emeb/bcc_sdr/README.md

bcc_sdr
=======

SDR daughtercard for BCC S6 FPGA board

All Files and Programmes Copyright 2014 Eric Brombaugh and/or Tom King

All Files and Programmes licensed under GPL v2 (See License.txt)
