emeb/bcc_sdr/Documentation/bcc_sdr_bom.ods

refdes | device | value | footprint | qty | tot qty | Manuf PN | Source | Source PN | Price (1) | Price(100) | min qty | 1- ext
C123 | CAPACITOR | 0.01uf | my_0402_sm | 1
C204 | CAPACITOR | 0.01uf | my_0402_sm | 1
C212 | CAPACITOR | 0.01uf | my_0402_sm | 1
C220 | CAPACITOR | 0.01uf | my_0402_sm | 1
C224 | CAPACITOR | 0.01uf | my_0402_sm | 1 | 5 | EMK105B7103KV-F |  | 587-2708-1-ND | $0.10 | $0.01 |  | $0.50
C106 | CAPACITOR | 0.1uf | my_0402_sm | 1
C108 | CAPACITOR | 0.1uf | my_0402_sm | 1
C109 | CAPACITOR | 0.1uf | my_0402_sm | 1
C112 | CAPACITOR | 0.1uf | my_0402_sm | 1
C113 | CAPACITOR | 0.1uf | my_0402_sm | 1
C114 | CAPACITOR | 0.1uf | my_0402_sm | 1
C115 | CAPACITOR | 0.1uf | my_0402_sm | 1
C116 | CAPACITOR | 0.1uf | my_0402_sm | 1
C117 | CAPACITOR | 0.1uf | my_0402_sm | 1
C118 | CAPACITOR | 0.1uf | my_0402_sm | 1
C119 | CAPACITOR | 0.1uf | my_0402_sm | 1
C120 | CAPACITOR | 0.1uf | my_0402_sm | 1
C121 | CAPACITOR | 0.1uf | my_0402_sm | 1
C122 | CAPACITOR | 0.1uf | my_0402_sm | 1
C124 | CAPACITOR | 0.1uf | my_0402_sm | 1
C203 | CAPACITOR | 0.1uf | my_0402_sm | 1
C211 | CAPACITOR | 0.1uf | my_0402_sm | 1
C219 | CAPACITOR | 0.1uf | my_0402_sm | 1
C225 | CAPACITOR | 0.1uf | my_0402_sm | 1
C302 | CAPACITOR | 0.1uf | my_0402_sm | 1
C304 | CAPACITOR | 0.1uf | my_0402_sm | 1
C306 | CAPACITOR | 0.1uf | my_0402_sm | 1
C311 | CAPACITOR | 0.1uf | my_0402_sm | 1
C313 | CAPACITOR | 0.1uf | my_0402_sm | 1
C315 | CAPACITOR | 0.1uf | my_0402_sm | 1 | 25 | EMK105B7104KV-F | digikey | 587-1451-1-ND | $0.10 | $0.01 |  | $2.50
C201 | CAPACITOR | 100pf | my_0402_sm | 1
C209 | CAPACITOR | 100pf | my_0402_sm | 1
C213 | CAPACITOR | 100pf | my_0402_sm | 1
C214 | CAPACITOR | 100pf | my_0402_sm | 1
C215 | CAPACITOR | 100pf | my_0402_sm | 1
C217 | CAPACITOR | 100pf | my_0402_sm | 1
C221 | CAPACITOR | 100pf | my_0402_sm | 1
C223 | CAPACITOR | 100pf | my_0402_sm | 1 | 8 | GRM1555C1H101GA01D | digikey | 490-6188-1-ND | $0.10 | $0.02 |  | $0.80
C301 | CAPACITOR | 10pf | my_0402_sm | 1
C303 | CAPACITOR | 10pf | my_0402_sm | 1
C305 | CAPACITOR | 10pf | my_0402_sm | 1
C310 | CAPACITOR | 10pf | my_0402_sm | 1
C312 | CAPACITOR | 10pf | my_0402_sm | 1
C314 | CAPACITOR | 10pf | my_0402_sm | 1 | 6 | GRM1555C1H100GA01D | digikey | 490-6187-1-ND | $0.10 | $0.03 |  | $0.60
C202 | CAPACITOR | 10uf 16V | my_0805 | 1
C210 | CAPACITOR | 10uf 16V | my_0805 | 1
C218 | CAPACITOR | 10uf 16V | my_0805 | 1
C226 | CAPACITOR | 10uf 16V | my_0805 | 1
C101 | CAPACITOR | 10uf 16V | my_0805 | 1
C102 | CAPACITOR | 10uf 16V | my_0805 | 1
C103 | CAPACITOR | 10uf 16V | my_0805 | 1
C107 | CAPACITOR | 10uf 16V | my_0805 | 1 | 8 | CL21B106KOQNNNE | digikey | 1276-2872-1-ND | $0.30 | $0.12 |  | $2.40
C309 | CAPACITOR | 1200pf | my_0402_sm | 1
C318 | CAPACITOR | 1200pf | my_0402_sm | 1 | 2 | CL05B122KB5NNNC | Digikey | 1276-1515-1-ND | $0.10 | $0.01 |  | $0.20
C104 | CAPACITOR | 18pf | my_0402_sm | 1
C105 | CAPACITOR | 18pf | my_0402_sm | 1 | 2 | GRM1555C1H180GA01D | Digikey | 490-6204-1-ND | $0.10 | $0.02 |  | $0.20
C319 | CAPACITOR | 1nf | my_0402_sm | 1
C320 | CAPACITOR | 1nf | my_0402_sm | 1
C321 | CAPACITOR | 1nf | my_0402_sm | 1
C322 | CAPACITOR | 1nf | my_0402_sm | 1 | 4 | CL05B102KB5NNNC | Digikey | 1276-1032-1-ND | $0.10 | $0.01 |  | $0.40
C205 | CAPACITOR | 200pf | my_0402_sm | 1
C208 | CAPACITOR | 200pf | my_0402_sm | 1 | 2 | GRM1555C1H201GA01D | Digikey | 490-6218-1-ND | $0.15 | $0.05 |  | $0.30
C307 | CAPACITOR | 2700pf | my_0402_sm | 1
C316 | CAPACITOR | 2700pf | my_0402_sm | 1 | 2 | CL05B272KB5NNNC | Digikey | CL05B272KB5NNNC | $0.10 | $0.01 |  | $0.20
C110 | CAPACITOR | 33pf | my_0402_sm | 1
C111 | CAPACITOR | 33pf | my_0402_sm | 1 | 2 | GRM1555C1H330GA01D | Digikey | 490-6232-1-ND | $0.10 | $0.02 |  | $0.20
C308 | CAPACITOR | 39nf | my_0402_sm | 1
C317 | CAPACITOR | 39nf | my_0402_sm | 1 | 2 | GRM1555C1H390GA01D | Digikey | 490-6235-1-ND | $0.10 | $0.02 |  | $0.20
C206 | CAPACITOR | 47pf | my_0402_sm | 1
C207 | CAPACITOR | 47pf | my_0402_sm | 1 | 2 | GRM1555C1H470GA01D | Digikey | 490-8206-1-ND | $0.10 | $0.02 |  | $0.20
D101 | DIODE | 1N4001 | SOD123 | 1
D301 | DIODE | 1N4001 | SOD123 | 1 | 2 | PMEG2010ER,115 | Digikey | 568-6504-1-ND | $0.48 | $0.21 |  | $0.96
J101 | HEADER46 | unknown | SHIELD-538-476_Lairdtech | 1 | 1 | FX2CA-40P-1.27DSA(71) | Digikey | H10567-ND | $3.83 | $3.06 |  | $3.83
J102 | HEADER8 | unknown | CONNECTOR 3 2 | 1 | 1
J103 | CONNECTOR_4 | unknown | JUMPER4 | 1 | 1
J104 | JUMPER | unknown | HEADER2_2 | 1 | 1
J201 | BNC | unknown | SMA_ENDLAUNCH | 1
J202 | BNC | unknown | SMA_ENDLAUNCH | 1 | 2 | 142-0701-801 | digikey | J502-ND | $5.09 | $3.33 |  | $10.18
L203 | INDUCTOR | 120nH | my_0402_sm | 1 | 1 | MLG1005SR12JT000 | Digikey | 445-3072-1-ND | $0.10 | $0.03 |  | $0.10
L202 | INDUCTOR | 180nH | my_0402_sm | 1
L204 | INDUCTOR | 180nH | my_0402_sm | 1 | 2 | MLF1005LR18K | Digikey | 445-6210-1-ND | $0.28 | $0.18 |  | $0.56
L101 | INDUCTOR | 2.2uH | vlf3010 | 1
L102 | INDUCTOR | 2.2uH | vlf3010 | 1 | 2 | VLF3010AT-2R2M1R0 | Digikey | 445-3215-1-ND | $0.90 | $0.60 |  | $1.80
L201 | INDUCTOR | 1.5uH | my_0805 | 1
L205 | INDUCTOR | 1.5uH | my_0805 | 1
L207 | INDUCTOR | 1.5uH | my_0805 | 1 | 3 | MLF2012A2R2KT000 | Digikey | 445-1051-1-ND | $0.20 | $0.11 |  | $0.60
L206 | INDUCTOR | 1.5uH | 1206_sm | 1 | 1 | CV201210-1R5K | Digikey | CV201210-1R5KCT-ND | $0.10 | $0.04 |  | $0.10
Q301 | BC817-25-7-F | unknown | SOT23-95P-240L1-3N__On-Semi_318-08-Package | 1 | 1 | BC817-25-7-F | Digikey | BC817-25FDICT-ND | $0.21 | $0.07 |  | $0.21
R105 | RESISTOR | 0 | my_0402_sm | 1 | 1 | RC0402FR-070RL | Digikey | 311-0LRCT-ND | $0.10 | $0.01 |  | $0.10
R108 | RESISTOR | 0 | my_0805 | 1
R109 | RESISTOR | 0 | my_0805 | 1 | 2 | RC0805JR-070RL | Digikey | 311-0.0ARCT-ND | $0.10 | $0.01 |  | $0.20
R304 | RESISTOR | 50 | my_0402_sm | 1
R305 | RESISTOR | 50 | my_0402_sm | 1
R306 | RESISTOR | 50 | my_0402_sm | 1
R307 | RESISTOR | 50 | my_0402_sm | 1
R311 | RESISTOR | 50 | my_0402_sm | 1
R312 | RESISTOR | 50 | my_0402_sm | 1 | 6 | RC0402FR-0750RL | Digikey | 311-50LRCT-ND | $0.10 | $0.01 |  | $0.60
R303 | RESISTOR | 360 | my_0402_sm | 1
R310 | RESISTOR | 360 | my_0402_sm | 1 | 2 | RC0402FR-07360RL | Digikey | 311-360LRCT-ND | $0.10 | $0.01 |  | $0.20
R302 | RESISTOR | 680 | my_0402_sm | 1
R309 | RESISTOR | 680 | my_0402_sm | 1 | 2 | RC0402FR-07680RL | Digikey | 311-680LRCT-ND | $0.10 | $0.01 |  | $0.20
R313 | RESISTOR | 1.0K | my_0402_sm | 1 | 1 | RC0402FR-071KL | Digikey | 311-1.00KLRCT-ND | $0.10 | $0.01 |  | $0.10
R101 | RESISTOR | 1.15M | my_0402_sm | 1
R103 | RESISTOR | 1.15M | my_0402_sm | 1 | 2 | CRCW04021M15FKED | Digikey | 541-1.15MLCT-ND | $0.09 | $0.03 |  | $0.18
R106 | RESISTOR | 1.96k | my_0402_sm | 1 | 1 | RC0402FR-071.96KRL | Digikey | 311-1.96KLRCT-ND | $0.10 | $0.01 |  | $0.10
R202 | RESISTOR | 14.3 1% | my_0402_sm | 1 | 1 | ERJ-2RKF14R3X | Digikey | P14.3LCT-ND | $0.10 | $0.02 |  | $0.10
R210 | RESISTOR | 16.5 1% | my_0402_sm | 1
R212 | RESISTOR | 16.5 1% | my_0402_sm | 1 | 2 | ERJ-2RKF16R5X | Digikey | P16.5LCT-ND | $0.10 | $0.02 |  | $0.20
R205 | RESISTOR | 18.2 1% | my_0402_sm | 1 | 1 | ERJ-2RKF18R2X | Digikey | P18.2LCT-ND | $0.10 | $0.02 |  | $0.10
R102 | RESISTOR | 255k | my_0402_sm | 1
R104 | RESISTOR | 255k | my_0402_sm | 1 | 2 | ERJ-2RKF2553X | Digikey | P255KLCT-ND | $0.10 | $0.02 |  | $0.20
R204 | RESISTOR | 34.8 1% | my_0402_sm | 1
R206 | RESISTOR | 34.8 1% | my_0402_sm | 1 | 2 | ERJ-2RKF34R8X | Digikey | P14.3LCT-ND | $0.10 | $0.02 |  | $0.20
R201 | RESISTOR | 37.4 1% | my_0402_sm | 1
R203 | RESISTOR | 37.4 1% | my_0402_sm | 1 | 2 | ERJ-2RKF37R4X | Digikey | P37.4LCT-ND | $0.10 | $0.02 |  | $0.20
R301 | RESISTOR | 4.7k | my_0402_sm | 1
R308 | RESISTOR | 4.7k | my_0402_sm | 1 | 2 | RC0402FR-074K7L | Digikey | 31104.7kLRCT-ND | $0.10 | $0.01 |  | $0.20
R207 | RESISTOR | 51 1% | my_0402_sm | 1
R208 | RESISTOR | 51 1% | my_0402_sm | 1 | 2 | ERJ-2RKF51R1X | Digikey | P51.1LCT-ND | $0.10 | $0.02 |  | $0.20
R209 | RESISTOR | 60 1% | my_0402_sm | 1
R213 | RESISTOR | 60 1% | my_0402_sm | 1 | 2 | ERJ-2RKF60R4X | Digikey | P60.4LCT-ND | $0.10 | $0.02 |  | $0.20
R211 | RESISTOR | 66.5 1% | my_0402_sm | 1 | 1 | ERJ-2RKF66R5X | Digikey | P66.5LCT-ND | $0.10 | $0.02 |  | $0.10
SH1 | SHIELD | unknown | SHIELD-538-476_Lairdtech | 1
SH2 | SHIELD | unknown | SHIELD-650-650_Lairdtech | 1
SH3 | SHIELD | unknown | SHIELD-650-650_Lairdtech | 1 | 2 | BMI-S-202-F | Digikey | 903-1051-1-ND | $1.51 | $1.20 |  | $3.02
SH4 | SHIELD | unknown | SHIELD-538-476_Lairdtech | 1
SH5 | SHIELD | unknown | SHIELD-538-476_Lairdtech | 1
SH6 | SHIELD | unknown | SHIELD-538-476_Lairdtech | 1
SH7 | SHIELD | unknown | SHIELD-538-476_Lairdtech | 1
SH8 | SHIELD | unknown | SHIELD-538-476_Lairdtech | 1 | 6 | BMI-S-201-F | Digikey | 903-1050-1-ND | $1.07 | $0.79 |  | $6.42
U105 | 74HC04 | unknown | DHVQFN14_eb | 1 | 1 | 74HC04BQ,115 | Digikey | 568-2592-1-ND | $0.46 | $0.30 |  | $0.46
U103 | AD9865 | unknown | CP-64-3 | 1 | 1 | AD9865BCPZ | Digikey | AD9865BCPZ-ND | $18.56 | $14.66 |  | $18.56
U301 | ADF4351 | unknown | LFCSP_VQ32 | 1
U302 | ADF4351 | unknown | LFCSP_VQ32 | 1 | 2 | ADF4351BCPZ | Digikey | ADF4351BCPZ-ND | $14.22 | $10.99 |  | $28.44
U104 | MCP23S08 | unknown | QFN20_4 | 1 | 1 | MCP23S08-E/ML | digikey | MCP23S08-E/ML-ND | $1.38 | $0.96 |  | $1.38
U106 | d75j | 40MHz - DNI | D75J | 1 | 0
U206 | HMC544 | unknown | SOT26 | 1 | 1 | HMC544E | Digikey | 1127-1055-1-ND | $3.23 | $2.60 |  | $3.23
U201 | PE4283 | unknown | SOT326 | 1
U204 | PE4283 | unknown | SOT326 | 1
U207 | PE4283 | unknown | SOT326 | 1
U209 | PE4283 | unknown | SOT326 | 1 | 4 | 4283-52 | Digikey | 1046-1030-1-ND | $1.02 | $0.81 |  | $4.08
U101 | NCP1532 | unknown | DFN10 | 1 | 1 | NCP1532MUAATXG | digikey | NCP1532MUAATXGOSCT-ND | $1.60 | $1.29 |  | $1.60
X101 | CRYSTAL | 40 MHz | XTAL_7A | 1 | 1 | ABM3-40.000MHZ-D2Y-F-T | digikey | 535-10650-1-ND | $1.20 | $0.99 |  | $1.20
 |  |  |  |  |  |  |  |  |  |  | total | $98.81
T101 | TC1-1T | TC1-1T | MINICIRCUITS_AT1521 | 1 | 1 | TC1-1TX+ | Mini-circuits |  | $2.19 | $1.19 | 20 | $2.19
T102 | ADT8-1T | ADT8-1T | MINICIRCUITS_CD637 | 1 | 1 | ADT8-1T | Mini-circuits |  | $4.50 |  | 20 | $4.50
U202 | ADE-1 | unknown | MINICIRCUITS_CD636 | 1
U208 | ADE-1 | unknown | MINICIRCUITS_CD636 | 1 | 2 | Ade-1 | Mini-circuits |  | $2.49 |  | 20 | $4.98
U203 | ERA-3+ | unknown | MINICIRCUITS_VV105 | 1
U205 | ERA-3+ | unknown | MINICIRCUITS_VV105 | 1
U211 | ERA-3+ | unknown | MINICIRCUITS_VV105 | 1 | 3 | ERA-3+ | Mini-circuits |  | $1.67 |  | 30 | $5.01
U210 | PSA4-5043+ | unknown | MINICIRCUITS_MMM1362 | 1 | 1 | PSA4-5043+ | Mini-circuits |  | $2.68 | $1.80 |  | $2.68
 |  |  |  |  |  |  |  |  |  |  | total | $19.36
 |  |  |  |  |  |  |  |  |  |  | total | $118.17
