emeb/bcc_sdr/(list of files, drawings)

Other design files:
bcc_sdr.pcb
bcc_sdr_tst.pcb
