emeb/bcc_sdr/(commit log)

2013-12-06 Added schematic source
    [bcc_sdr_pg1.sch, bcc_sdr_pg2.sch]
2013-12-06 added TX input network to upconverter
    [bcc_sdr_pg2.sch]
2013-12-06 Corrected T202's Model to a 16:1 transformer
    [bcc_sdr_pg2.sch]
2013-12-06 added bias resistor values for amps
    [bcc_sdr_pg2.sch]
2013-12-06 Changed U204 Part # to correct one.
    [bcc_sdr_pg2.sch]
2013-12-07 Fix xfrmr pinouts
    [bcc_sdr_pg1.sch, bcc_sdr_pg2.sch]
2013-12-07 Added footprints for known parts
    [bcc_sdr_pg2.sch]
2013-12-07 Added 0805 footprints
    [bcc_sdr_pg2.sch]
2013-12-07 Added Bias to U207 output, Change T202 to TC8-1+
    [bcc_sdr_pg2.sch]
2013-12-07 Update transformer footprints
    [bcc_sdr_pg1.sch, bcc_sdr_pg2.sch]
2013-12-07 Correct amp footprint name
    [bcc_sdr_pg2.sch]
2013-12-07 Update mixer and switch footprints
    [bcc_sdr_pg2.sch]
2013-12-07 Fix PLL footprint, fix RX SMA refdes, add SMA labels
    [bcc_sdr_pg2.sch]
2013-12-08 Break out PLL on separate page, prep for new mixers
    [bcc_sdr_pg1.sch, bcc_sdr_pg2.sch, bcc_sdr_pg3.sch]
2013-12-08 Added new mixers, added 7 pole Butterworth HPF for TX side, Added Pads on outputs of Mixers for stability
    [bcc_sdr_pg2.sch]
2013-12-08 Cleanup refdes, connectivity, add author
    [bcc_sdr_pg2.sch]
2013-12-08 Initial footprints
    [bcc_sdr.pcb, bcc_sdr_pg1.sch, bcc_sdr_pg2.sch, bcc_sdr_pg3.sch]
2013-12-08 Use IAMP output of TX path for more power to mixer.
    [bcc_sdr_pg1.sch]
2013-12-08 Added 1st pass of Block/Level for TX side
    [BCC_SDR_Block_Level.ods]
2013-12-08 Added new Makeup Amp in RX path, Created (Very) rough pads for paths.
    [bcc_sdr_pg2.sch]
2013-12-08 Added correct resistor values for pads.
    [bcc_sdr_pg2.sch]
2013-12-09 added RX path to Block and Level
    Changed ERA3's for PSA4 amps.
    [BCC_SDR_Block_Level.ods, bcc_sdr_pg2.sch]
2013-12-10 Added RX system gain information for High/Low gain PGA for both 0-30mhz and VHF paths.
    [BCC_SDR_Block_Level.ods]
2013-12-10 Reworked RX gain paths based upon better understaning of processing gains and SNR of 9865 part.
    [BCC_SDR_Block_Level.ods]
2013-12-10 Updated with latest codec footprint, fix RF net, update PCB
    [bcc_sdr.pcb, bcc_sdr_pg1.sch, bcc_sdr_pg2.sch]
2013-12-10 Added second sheet of design ODS with Supply Currents
    [BCC_SDR_Block_Level.ods]
2013-12-11 Added final values for RX pad.
    [BCC_SDR_Block_Level.ods, bcc_sdr_pg2.sch]
2013-12-11 Add jumper and footprint
    [bcc_sdr_pg2.sch, bcc_sdr_pg3.sch]
2013-12-11 made room on pcb for starting layout
    [bcc_sdr.pcb]
2013-12-11 swap in new jumpers
    [bcc_sdr.pcb]
2013-12-11 Initial Layout - VERY ROUGH - Will need to be fit inside RF Shielding
    [bcc_sdr.pcb]
2013-12-12 add power connector, enlarge board
    [bcc_sdr.pcb, bcc_sdr_pg1.sch]
2013-12-22 added more information on the block/level
    continued work on RF bits on layout.
    [BCC_SDR_Block_Level.ods, bcc_sdr.pcb]
2013-12-22 Updated 0603 footprints
    [bcc_sdr.new.pcb, bcc_sdr.pcb, bcc_sdr_pg1.sch, bcc_sdr_pg2.sch, bcc_sdr_pg3.sch]
2013-12-29 Updated w/ small 0402 footprints, DHVQFN14 and added supply line
    [bcc_sdr.pcb, bcc_sdr_pg1.sch, bcc_sdr_pg2.sch, bcc_sdr_pg3.sch]
2013-12-29 Swap in QFN version of MCP port expander
    [bcc_sdr.pcb, bcc_sdr_pg1.sch]
2013-12-29 Add outline to all 0402, route hirose
    [bcc_sdr.pcb, bcc_sdr_pg1.sch]
2013-12-29 More routing on hirose conn
    [bcc_sdr.pcb]
2013-12-29 moved passives into TX shields for fit check
    [bcc_sdr.pcb]
2013-12-29 added RX passives to shield areas for fit checks
    [bcc_sdr.pcb]
2013-12-30 Fix short in RX chain, swap in new PLL footprints, push doghouse outlines to unused layer
    [bcc_sdr.pcb]
2013-12-30 Added Passives for LOs to board
    [bcc_sdr.pcb]
2013-12-30 Added Amplifier Key Circuit
    [bcc_sdr.pcb, bcc_sdr_pg3.sch]
2013-12-30 Added Snubber Diode on OC Key Circuit
    [bcc_sdr_pg3.sch]
2013-12-30 Replaced LDO's with NCP1532 circuit
    added footprint for Key Transistor
    [bcc_sdr_pg1.sch, bcc_sdr_pg3.sch]
2013-12-30 embedded components on Pg1
    [bcc_sdr_pg1.sch]
2013-12-30 Added power net for HCT04
    [bcc_sdr_pg1.sch]
2013-12-31 Swap in new footprints, fix reverted schematics
    [bcc_sdr.pcb, bcc_sdr_pg1.sch]
2013-12-31 embed new sym
    [bcc_sdr_pg1.sch]
2013-12-31 Resized Outline
    [bcc_sdr.pcb]
2013-12-31 renumbered schematic pg1
    changed transistor Q301
    [bcc_sdr_pg1.sch, bcc_sdr_pg3.sch]
2014-01-01 Updates to schematic, cleanup layout and place/route around codec
    [bcc_sdr.pcb, bcc_sdr_pg1.sch, bcc_sdr_pg3.sch]
2014-01-01 Placed smps, reduced X dim to board max
    [bcc_sdr.pcb]
2014-01-02 PCB: Moved Crowbar diode
    Design Doc: Added more content...filling in more of Analogue sections.
    [bcc_sdr.pcb]
2014-01-04 Switched to Geneva as Times New Roman didn't universally display
2014-01-04 check schematic before conversion
    [block.sch]
2014-01-04 Added Analogue Language to the Design Document.
    Completed Block Diagramme
    [block.sch]
2014-01-04 Added TP203-205/J202 to page 1 for PS testpoints and Offboard PS if necessary
    Corrected Arrow direction problem on TX DAC
    [bcc_sdr_pg1.sch, block.sch]
2014-01-04 added License file
    [block.sch]
2014-01-04 Moved Documentation into separate folder
    [BCC_SDR_Block_Level.ods, block.sch]
2014-01-05 added system block
    [System_Block.sch]
2014-01-05 Added top-level block diagram
    [System_Block.sch]
2014-01-05 Added TCXO
    [bcc_sdr.pcb, bcc_sdr_pg1.sch]
2014-01-06 Added Shields to Pg 3
    [bcc_sdr_pg3.sch]
2014-01-06 Corrected SH6 Shield fp attribute
    [bcc_sdr_pg3.sch]
2014-01-06 Added SH1 and SH2 FPs
    [bcc_sdr_pg3.sch]
2014-01-06 Placed shields
    [bcc_sdr.pcb]
2014-01-06 Moved things around inside the shields...moved the shields around so we had soldering room
    [bcc_sdr.pcb]
2014-01-07 Added PLL in/out blockers, supply interrupts, power testpoints
    [bcc_sdr.pcb, bcc_sdr_pg1.sch, bcc_sdr_pg3.sch]
2014-01-07 Moved RX mixer to replace shield with smaller .476 X .538 model so we can get more space for the PLL parts
    Changed SH1 to SHIELD-538-476_Lairdtech.fp
    [bcc_sdr.pcb, bcc_sdr_pg3.sch]
2014-01-07 smaller shield
    [bcc_sdr.pcb]
2014-01-07 PCB - Moved RX preamp components around to allow shield to be the smaller .538X.476 one
    Pg3 changed SH4 FP to SHIELD-538-476_Lairdtech.fp
    [bcc_sdr.pcb, bcc_sdr_pg3.sch]
2014-01-07 smaller lna shield
    [bcc_sdr.pcb]
2014-01-07 PCB = Moved around things to make more space and still keep things clean (enough)
    [bcc_sdr.pcb]
2014-01-07 Relocate RX balun
    [bcc_sdr.pcb]
2014-01-07 Pg3 - Changed SH5 to .538X.476. Added Shields 7,8 (.538X.476) for LOs
    [bcc_sdr_pg3.sch]
2014-01-07 Added pll shields
    [bcc_sdr.pcb]
2014-01-07 Fixed SH5 Shield size
    Added Grounds to SH7, SH8
    [bcc_sdr_pg3.sch]
2014-01-07 Correct shields
    [bcc_sdr.pcb]
2014-01-07 Moved shelds around...ready for routing!
    [bcc_sdr.pcb]
2014-01-07 Added first 12mil 50ohm traces (RX jumper to connector and switches
    [bcc_sdr.pcb]
2014-01-07 Checking 12mil lines
    [bcc_sdr.pcb]
2014-01-07 Routing RF Front end and final
    swapped RF lines on the final switch to make it easier to route
    [bcc_sdr.pcb, bcc_sdr_pg2.sch]
2014-01-07 fixed clearance for 50ohm lines
    [bcc_sdr.pcb]
2014-01-07 progress push
    [bcc_sdr.pcb]
2014-01-07 More Layout....trying to make the DRC happy...
    [bcc_sdr.pcb]
2014-01-07 Swapped RF1 and RF2 on U201 to accomodate layout - Pg2
    Fixed Netlist issues on board
    [bcc_sdr.pcb, bcc_sdr_pg2.sch]
2014-01-08 Finished routing RF for TX section
    [bcc_sdr.pcb]
2014-01-08 Routing Receive Section RF
    [bcc_sdr.pcb]
2014-01-08 Added space for shield soldering and RF switch Grounds
    [bcc_sdr.pcb]
2014-01-08 align sch & pcb on switch swaps
    [bcc_sdr.pcb, bcc_sdr_pg2.sch]
2014-01-08 Fixed more Errors
    Added RX mixer and post amp 50ohm routing
    [bcc_sdr.pcb]
2014-01-08 clean up switches, prelim route PS, clean up shorts
    [bcc_sdr.pcb, bcc_sdr_pg1.sch, bcc_sdr_pg2.sch]
2014-01-08 Added Therms for Grounds and power
    [bcc_sdr.pcb]
2014-01-08 Fix busted vias
    [bcc_sdr.pcb]
2014-01-08 5V plane, route switches
    [bcc_sdr.pcb]
2014-01-08 minor tweak
    [bcc_sdr.pcb]
2014-01-08 Fix up missing netlist stuff
    [bcc_sdr.pcb, bcc_sdr_pg1.sch, bcc_sdr_pg2.sch]
2014-01-08 Rework from U207 to U209
    [bcc_sdr.pcb]
2014-01-08 Fixed TX to GND short
    [bcc_sdr.pcb]
2014-01-08 Fix PLL routing and resolve netlist for RF RX reroute
    [bcc_sdr.pcb, bcc_sdr_pg1.sch]
2014-01-08 route rx mixer bypass
    [bcc_sdr.pcb]
2014-01-09 Route RX, fix shorts
    [bcc_sdr.pcb, bcc_sdr_pg2.sch]
2014-01-12 Preliminary LO Layout...
    [bcc_sdr.pcb]
2014-01-12 Swapped LO1 and LO0 on Pg2(Because it was backwards)
    Swapped LO0 and LO1A on Pg3 (for better layout)
    [bcc_sdr_pg2.sch, bcc_sdr_pg3.sch]
2014-01-12 begin routing of LO0
    [bcc_sdr.pcb]
2014-01-13 Reverted to correct versions
    [bcc_sdr_pg2.sch, bcc_sdr_pg3.sch]
2014-01-13 Swapped LOs on Pg2 and Pg3
    [bcc_sdr_pg2.sch, bcc_sdr_pg3.sch]
2014-01-13 Synced schematic & layout, fixed netlist, routed TR switch driver
    [bcc_sdr.pcb, bcc_sdr_pg3.sch]
2014-01-13 Really fixed LO0 and LO1 on Pg2
    [bcc_sdr_pg2.sch]
2014-01-13 Fix LO nets
    [bcc_sdr.pcb]
2014-01-13 Routing LO0
    [bcc_sdr.pcb]
2014-01-13 Routed Bypass Caps for U301 - Pushed back for DRC check on Vias and Therms
    [bcc_sdr.pcb]
2014-01-13 rework the shields
    [bcc_sdr.pcb]
2014-01-14 fixed the TX mixer lines
    [bcc_sdr.pcb]
2014-01-14 resync schematic & layout, fix some violations
    [bcc_sdr.pcb, bcc_sdr_pg2.sch]
2014-01-14 Moved around the VIAs for U301, checking for DRC
    [bcc_sdr.pcb]
2014-01-14 Routing Power and Ground to U301
    [bcc_sdr.pcb]
2014-01-14 Added Filter Line for PLL
    [bcc_sdr.pcb]
2014-01-14 sync sch & pcb to fix shorted LO0 cap
    [bcc_sdr.pcb, bcc_sdr_pg3.sch]
2014-01-14 Finished routing LO0
    [bcc_sdr.pcb]
2014-01-14 Extend +5V plane, route some PLL digital stuff
    [bcc_sdr.pcb]
2014-01-14 Compleated Analogue Layout...now onto Control
    [bcc_sdr.pcb]
2014-01-14 route additional PLL signals on L4
    [bcc_sdr.pcb]
2014-01-14 Fix disconnected PLL SPI
    [bcc_sdr.pcb, bcc_sdr_pg3.sch]
2014-01-15 Fix 50 ohm clearance
    [bcc_sdr.pcb]
2014-01-15 added trial top gnd plane
    [bcc_sdr_tst.pcb]
2014-01-15 Tested 60% Labels for component REFDES on bcc_sdr_tst.pcb
    [bcc_sdr_tst.pcb]
2014-01-15 reduced size of typing by 40%, placed refdes as close as possible to components
    [bcc_sdr.pcb]
2014-01-17 Added addtional Bypass Cap for U104 MCP part
    [bcc_sdr_pg1.sch]
2014-01-17 Fix some shorts
    [bcc_sdr.pcb]
2014-01-17 Add gnd pad for 04, route MCP bypass
    [bcc_sdr.pcb, bcc_sdr_pg1.sch]
2014-01-17 Add gnd pads for ADI parts
    [bcc_sdr.pcb, bcc_sdr_pg3.sch]
2014-01-17 Reworked Pg2
    - Changed amps to ones that are good to DC
    - Created Separate paths for HF RX and VHF RX (due to Pre-amp issues)
    - HF now is direct path, no Preamp. still 0.1uV RX.
    - Will need to recalculate Post Mixer and Post DAC Pads.
    [bcc_sdr_pg2.sch]
2014-01-17 Changed the RX post mixer amp to ERA-3+ (as it needs to go to DC)
    [bcc_sdr_pg2.sch]
2014-01-17 Remove LNA in HF path, swap in ERA amps for all but VHF LNA
    [bcc_sdr.pcb, bcc_sdr_pg2.sch]
2014-01-17 codec gnd pad
    [bcc_sdr.pcb, bcc_sdr_pg1.sch]
2014-01-20 moved RF lines inside the shields
    [bcc_sdr.pcb]
2014-01-20 Thickened up grounds on RF bits
    [bcc_sdr.pcb]
2014-01-20 Cleaned up more of the RF
    [bcc_sdr.pcb]
2014-01-20 added copyright
    [bcc_sdr.pcb]
2014-01-20 Added OSHW Logo
    [bcc_sdr.pcb]
2014-01-20 Added Callsigns and BCC_SDR to Silk
    [bcc_sdr.pcb]
2014-01-20 Added GPLv2 and V0.1
    [bcc_sdr.pcb]
2014-01-20 Minor fixes to make sure that silk printing isn't on top of VIAs
    [bcc_sdr.pcb]
2014-01-24 Added J103 for Tune/PTT
    Added J102 for BBB independent opertations (+5v input)
    [bcc_sdr_pg1.sch]
2014-01-24 Updated PCB with new connectors
    [bcc_sdr.pcb, bcc_sdr_pg1.sch]
2014-01-25 Fix wide clearance on some 50ohm lines
    [bcc_sdr.pcb]
2014-01-25 Added Vias and Therms for Shields
    Routed L4 to avoid Shield VIas and Therms
    Removed J105 from PCB (no room)
    [bcc_sdr.pcb]
2014-01-26 Top Fill First Pass...more stitching to come!
    [bcc_sdr.pcb]
2014-01-26 Minor tweaks...passing back to sort out groundplane
    [bcc_sdr.pcb]
2014-01-26 Remove power connector from netlist, fix gnd plane
    [bcc_sdr.pcb, bcc_sdr_pg1.sch]
2014-01-26 Clean up diagonals on L1 gnd plane
    [bcc_sdr.pcb]
2014-01-26 adding vias and therms to tie top plane to ground plane
    [bcc_sdr.pcb]
2014-01-26 rerouted RX mixer output
    [bcc_sdr.pcb]
2014-01-26 added more therms and moved U302 Refdes out from under the part
    [bcc_sdr.pcb]
2014-01-26 Final push before adding no-clear lines to shield
    [bcc_sdr.pcb]
2014-01-26 test of no-clear lines
    [bcc_sdr.pcb]
2014-01-26 added no-clear lines to shield pads to tie into top ground
    [bcc_sdr.pcb]
2014-01-26 finished up no-clear lines and adding therms for top grounding
    [bcc_sdr.pcb]
2014-01-26 Added a few more therms to make sure we didn't have any islands of Top Ground isolated
    [bcc_sdr.pcb]
2014-01-26 fixed missing Power therm for U211
    [bcc_sdr.pcb]
2014-01-26 fixed shorts
    [bcc_sdr.pcb]
2014-01-26 fixed DVDD to GND short
    [bcc_sdr.pcb]
2014-01-26 Cleanups, improve routing on spms, improve gnd connections on codec
    [bcc_sdr.pcb]
2014-01-27 removed Vias from Pads as Open Vias on pads is a No No
    [bcc_sdr.pcb]
2014-01-27 move Vias out of pads (specifically the ERA+ Grounds)
    [bcc_sdr.pcb]
2014-01-27 fixing Top groundplane DRC's
    [bcc_sdr.pcb]
2014-01-27 Pushing back so we can see why its unhappy with the centre top groundplane
    [bcc_sdr.pcb]
2014-01-31 Widen mask openings on shield pads
    [bcc_sdr.pcb]
2014-01-31 Clean up DRCs
    [bcc_sdr.pcb]
2014-01-31 Fix route styles for older PCB version
    [bcc_sdr.pcb]
2014-02-11 Add oshpark gerber script
2014-02-11 added windowpane paste mask for large center pads
    [bcc_sdr.pcb]
2014-02-11 Clean up refdes
    [bcc_sdr.pcb]
2014-02-12 increased sizes of RFC's for the MCL Amps
    [bcc_sdr_pg2.sch]
2014-02-12 swap in larger parts for the amp supply lines
    [bcc_sdr.pcb]
2014-02-14 added right sized inductors for feeding amps to layout
    [bcc_sdr.pcb]
2014-02-14 making some room in SH8
    [bcc_sdr.pcb]
2014-02-15 Fixed final RefDes and added better Therms for the top layer
    [bcc_sdr.pcb]
2014-02-15 Added Therms from the Top to the Ground Layer that are Solid (nobody soldering here)
    [bcc_sdr.pcb]
2014-02-15 Update for BOM
2014-02-15 Fixed 6db RX pad values
    [bcc_sdr_pg2.sch]
2014-02-15 Initial BOM
    [bcc_sdr_bom.ods]
2014-02-15 Added Manuf PN, Source and Cost fields
    Added Capacitor information for HPF
    [bcc_sdr_bom.ods]
2014-02-15 Fill in bom details
    [bcc_sdr_bom.ods]
2014-02-17 Add mini-circuits
    [bcc_sdr_bom.ods]
2014-02-23 Added cap part nums
    [bcc_sdr_bom.ods]
2014-02-25 added more BOM entries
    [bcc_sdr_bom.ods]
2014-02-25 all components in BOM except Connectos/Jumpers
    [bcc_sdr_bom.ods]
2014-02-28 Add hirose, totals
    [bcc_sdr_bom.ods]
2014-03-07 changed precision oscillator out for External Reference Input
    [bcc_sdr_pg1.sch]
2014-03-07 Fix inductor footprint
    [bcc_sdr_pg2.sch]
2014-03-07 changed LO Reference input connector to J105
    [bcc_sdr.pcb, bcc_sdr_pg1.sch]
2014-03-08 swapped out TCXO for SMA offboard LO reference input
    [bcc_sdr.pcb]
2014-03-09 moved traces to avoid new SMA
    [bcc_sdr.pcb]
2014-03-09 redo gnd plane near clk in
    [bcc_sdr.pcb]
2014-03-09 Fix DRCs due to floating trace
    [bcc_sdr.pcb]
2014-03-10 fixed main feed problem
    [bcc_sdr.pcb]
2014-03-10 trying ti center the power in the holes...no luck
    [bcc_sdr.pcb]
2014-03-10 clean up short, finish gnd attach on back side
    [bcc_sdr.pcb]
2014-03-12 Swap in updated LFCSP_VQ32 with longer pads
    [bcc_sdr.pcb]
2014-03-12 fixed DRC issues due to increased size of 4351 pads
    [bcc_sdr.pcb]
2014-03-13 Fix DRCs and L1 area fill
    [bcc_sdr.pcb]
2014-03-13 swap qfn20_4_ep for mcp
    [bcc_sdr.pcb]
2014-03-13 Fix gnd fill by moving qfn20_4_ep earlier in the .pcb file
    [bcc_sdr.pcb]
